oddsocks1024/Turboload-Sock-and-Load/schematics/Turboload Sock and Load schematics 1.0 bw.pdf

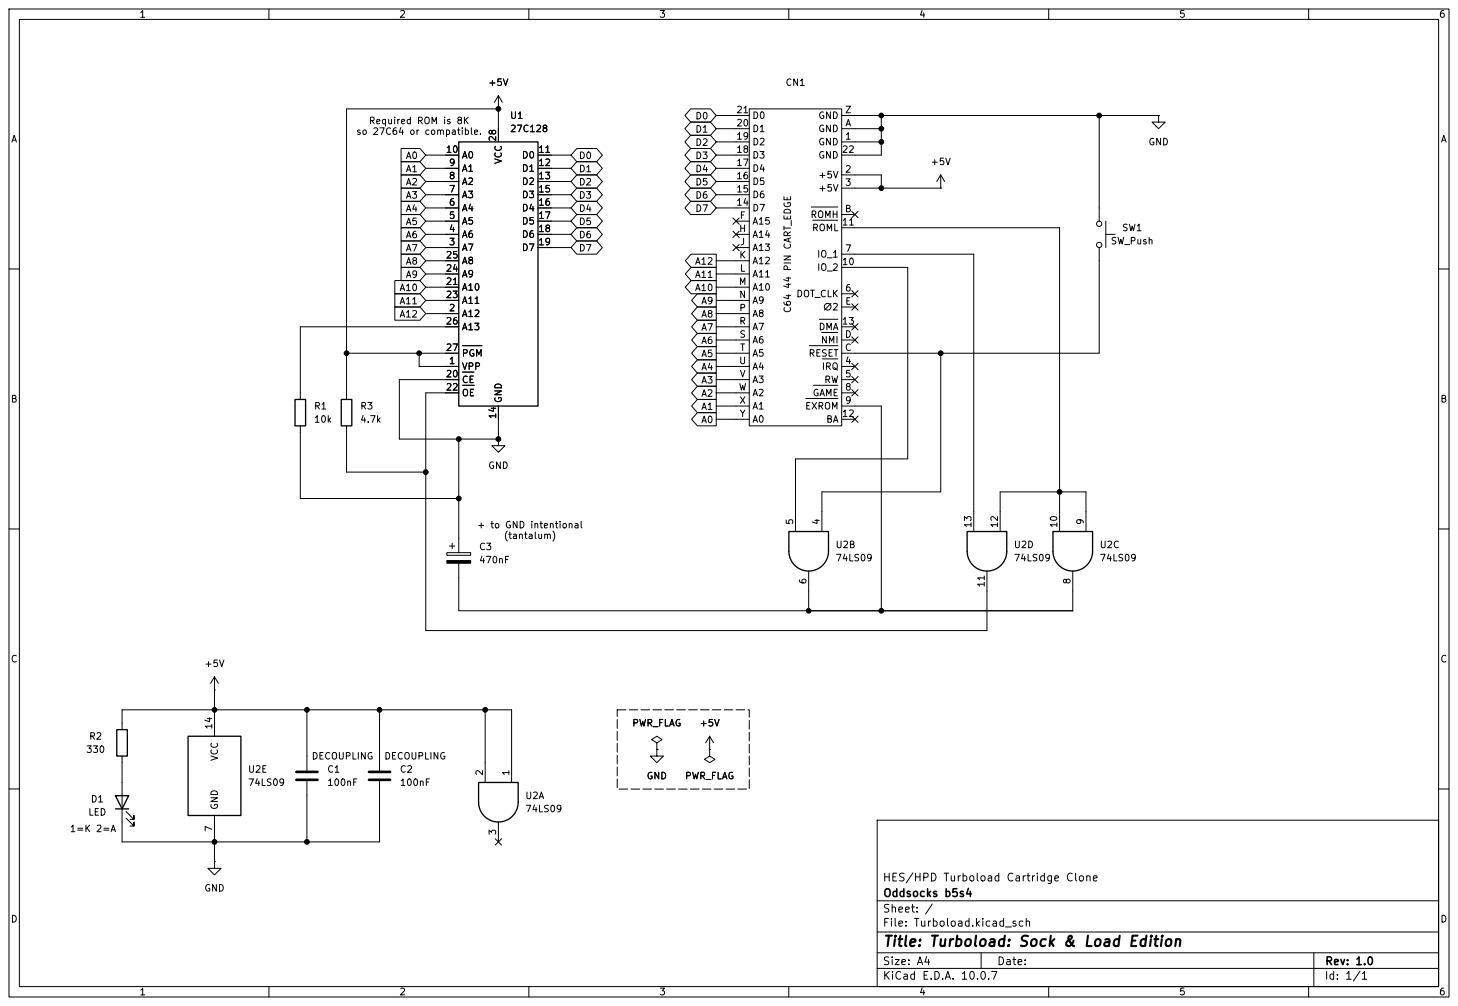
[picture p4: page 1]

so 27C64 or compatible.+ to GND intentional (tantalum) DECOUPLING
A0 DECOUPLING

HES/HPD Turboload Cartridge Clone
Oddsocks b5s4
Sheet: /
File: Turboload.kicad_sch
Title: Turboload: Sock & Load Edition

Size: A4 | Rev: 1.0
KiCad E.D.A. 10.0.7 | Id: 1/1
