oddsocks1024/Turboload-Sock-and-Load/KiCAD-Project/Turboload.kicad_pcb

## KiCad design KiCAD-Project/Turboload.kicad_pcb (2026-10-31)

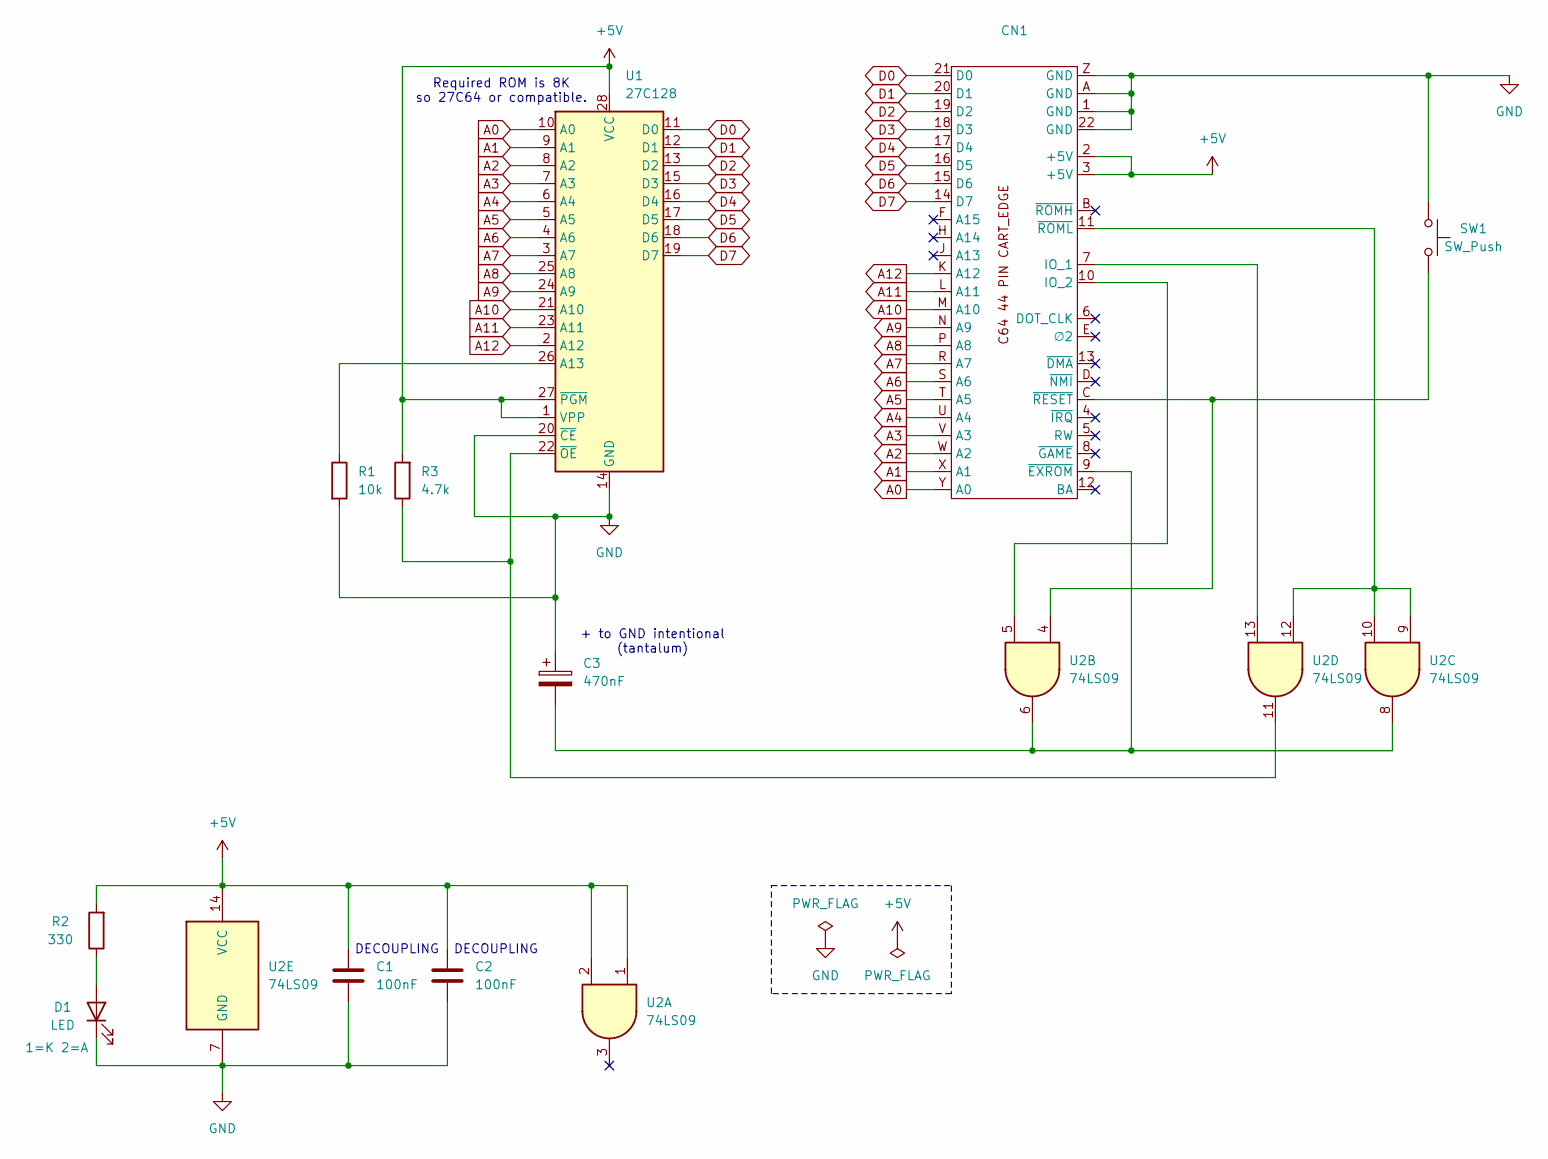
[picture p5: schematic Turboload.kicad_sch, Turboload: Sock & Load Edition]

Parts:
C1, C2: 100nF; C_Disc_D3.0mm_W2.0mm_P2.50mm
C3: 470nF; C_Disc_D3.0mm_W2.0mm_P2.50mm
CN1: C64 Expansion
D1: LED; LED_D5.0mm
R1: 10k; R_Axial_DIN0207_L6.3mm_D2.5mm_P10.16mm_Horizontal
R2: 330; R_Axial_DIN0207_L6.3mm_D2.5mm_P10.16mm_Horizontal
R3: 4.7k; R_Axial_DIN0207_L6.3mm_D2.5mm_P10.16mm_Horizontal
SW1: SW_Push; SW_PUSH_6mm
U1: 27C128; DIP-28_W15.24mm
U2: 74LS09; DIP-14_W7.62mm

Connections:
+5V: C1.2, C2.2, CN1.2 (+5V), CN1.3 (+5V), R2.2, R3.2, U1.1 (VPP), U1.27 (~PGM), U1.28 (VCC), U2.1, U2.2, U2.14 (VCC)
A0: CN1.Y (A0), U1.10 (A0)
A1: CN1.X (A1), U1.9 (A1)
A2: CN1.W (A2), U1.8 (A2)
A3: CN1.V (A3), U1.7 (A3)
A4: CN1.U (A4), U1.6 (A4)
A5: CN1.T (A5), U1.5 (A5)
A6: CN1.S (A6), U1.4 (A6)
A7: CN1.R (A7), U1.3 (A7)
A8: CN1.P (A8), U1.25 (A8)
A9: CN1.N (A9), U1.24 (A9)
A10: CN1.M (A10), U1.21 (A10)
A11: CN1.L (A11), U1.23 (A11)
A12: CN1.K (A12), U1.2 (A12)
D0: CN1.21 (D0), U1.11 (D0)
D1: CN1.20 (D1), U1.12 (D1)
D2: CN1.19 (D2), U1.13 (D2)
D3: CN1.18 (D3), U1.15 (D3)
D4: CN1.17 (D4), U1.16 (D4)
D5: CN1.16 (D5), U1.17 (D5)
D6: CN1.15 (D6), U1.18 (D6)
D7: CN1.14 (D7), U1.19 (D7)
GND: C1.1, C2.1, C3.1, CN1.1 (GND), CN1.22 (GND), CN1.A (GND), CN1.Z (GND), D1.1 (K), R1.2, SW1.1, U1.14 (GND), U1.20 (~CE), U2.7 (GND)
unnamed: CN1.7 (IO_1), U2.13
unnamed: CN1.10 (IO_2), U2.5
unnamed: C3.2, CN1.9 (~EXROM), U2.6, U2.8
unnamed: CN1.C (~RESET), SW1.2, U2.4
unnamed: CN1.11 (~ROML), U2.9, U2.10, U2.12
unnamed: D1.2 (A), R2.1
unnamed: R1.1, U1.26 (A13)
unnamed: R3.1, U1.22 (~OE), U2.11

Notes on the sheet:
DECOUPLING
+ to GND intentional (tantalum)
Required ROM is 8K so 27C64 or compatible.

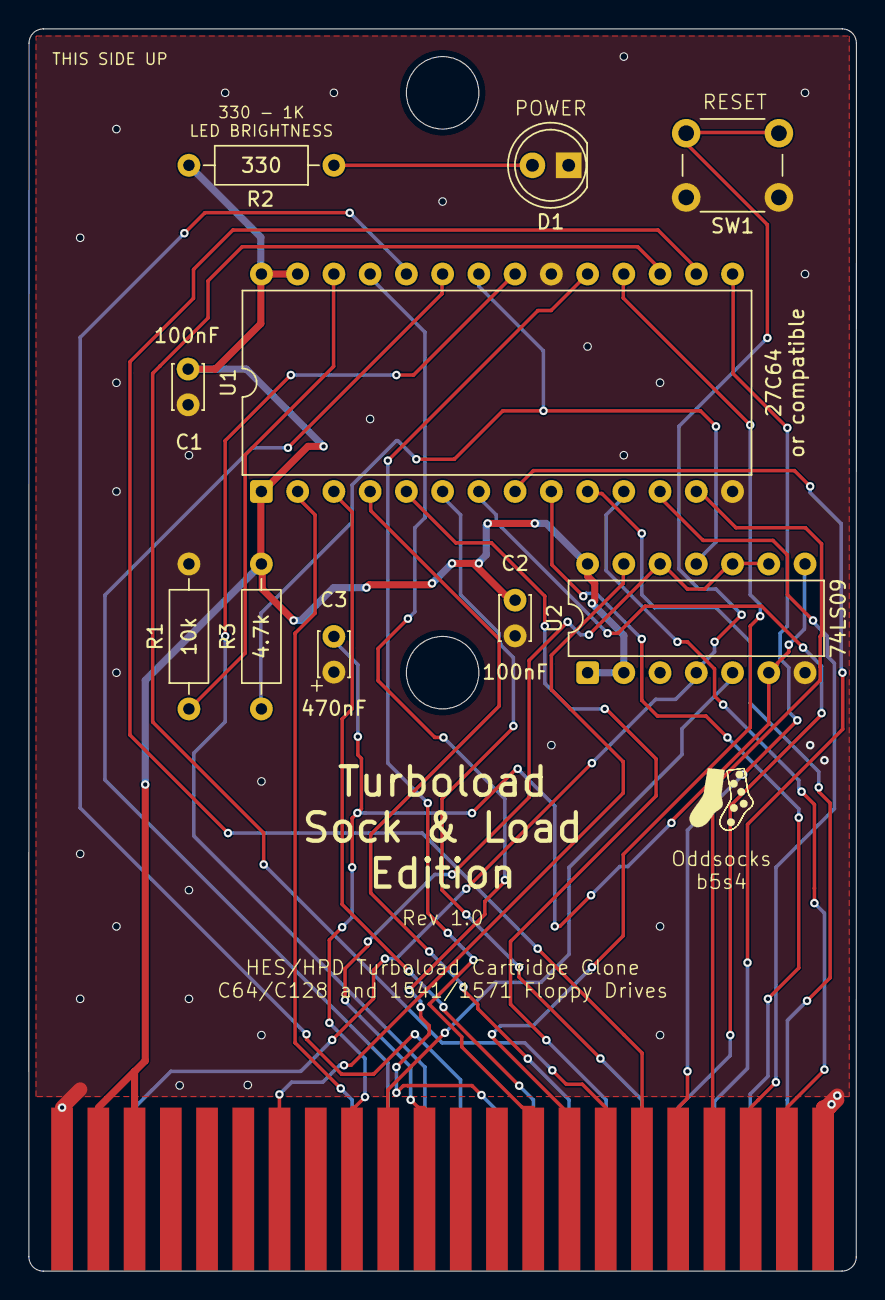
[picture p6: board Turboload.kicad_pcb from above]

Board: 2 copper layers, 58.0 x 87.1 mm, 11 parts (0 on the bottom side), 31 nets.
