oddsocks1024/Turboload-Sock-and-Load/dos-commands/turboload_instructions.png

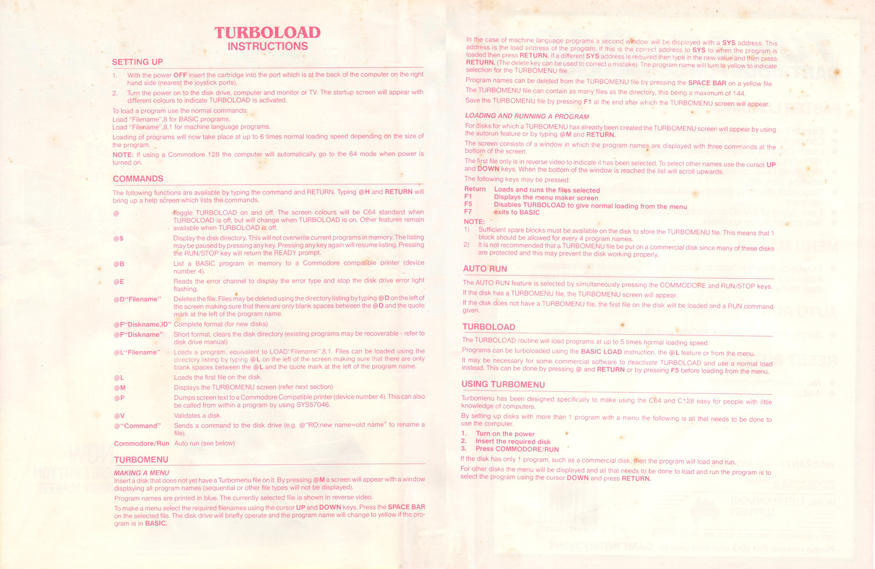
dos-commands/turboload_instructions.png
